Automation-group/DigitalAmmeter/photo/IMG_20190522_160255.jpg

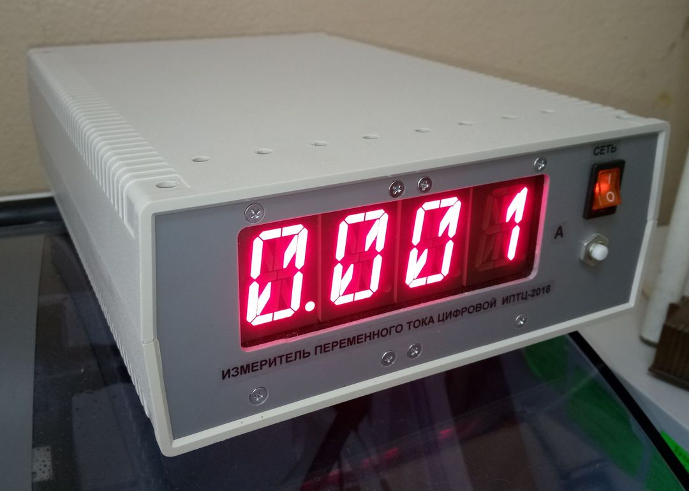
photo/IMG_20190522_160255.jpg
