Automation-group/DigitalAmmeter/photo/IMG_20190522_160238.jpg

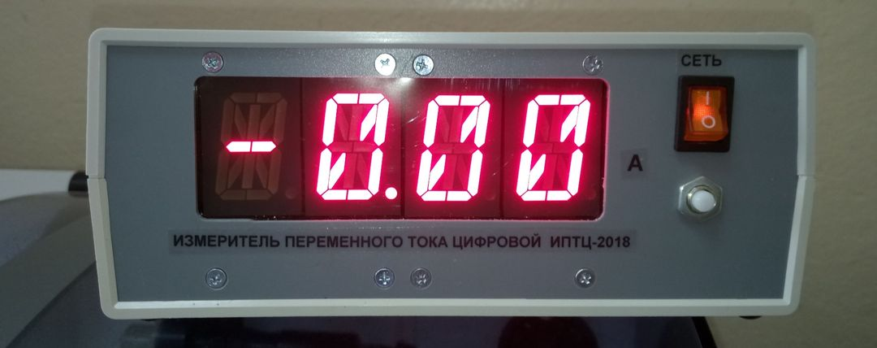
photo/IMG_20190522_160238.jpg
