Automation-group/DigitalAmmeter/source_files/Title-DA-2018.docx

ИЗМЕРИТЕЛЬ ПЕРЕМЕННОГО ТОКА ЦИФРОВОЙ ИПТЦ-2018 Тл А

СЕТЬ СЕТЬ 220 В 50 Гц ПР 1 А ВХОД USB

А/ед НИФТИ ННГУ № 01 2018 г.
