Automation-group/DigitalAmmeter/application/Application_A_7.pdf

Рис. 7

Макетное поле модуля микроконтроллера. Схема электрическая принципиальная.

Приложение А
