Automation-group/DigitalAmmeter/photo/IMG_20190522_160358.jpg

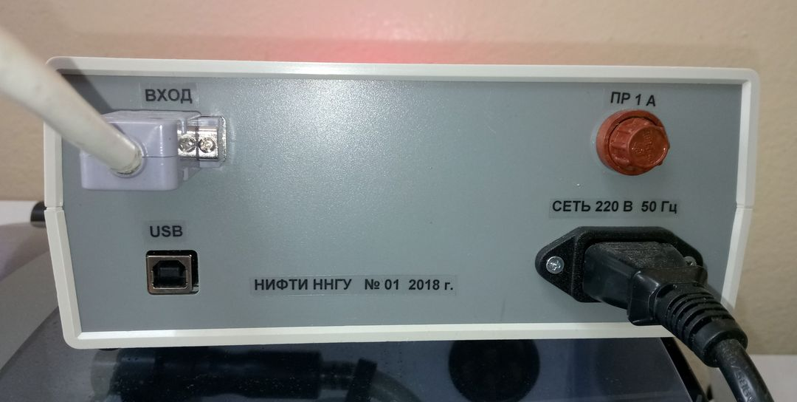
photo/IMG_20190522_160358.jpg
