Automation-group/DigitalAmmeter/application/Application_A_1.pdf

A1

## ИПТЦ-2018

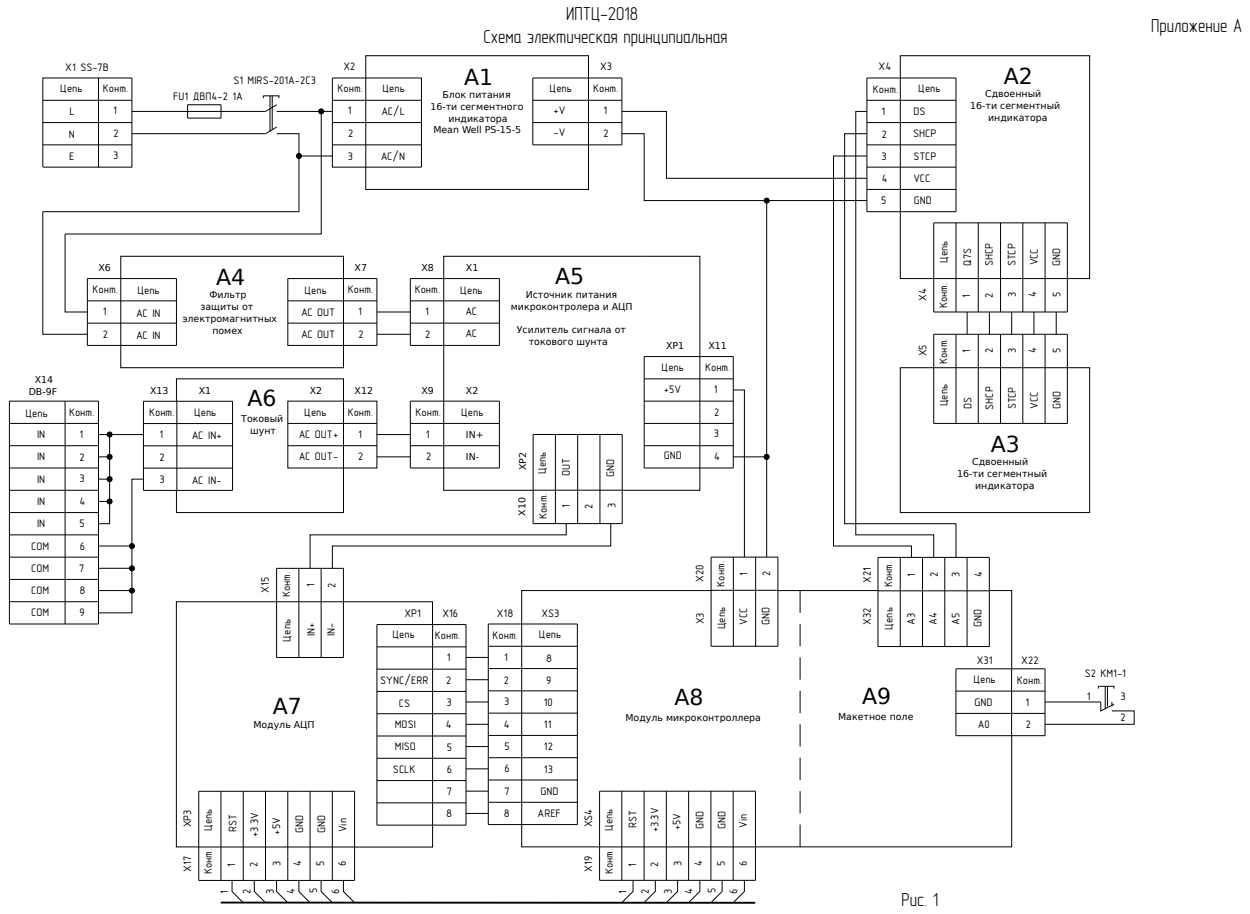
[picture p6: page 1]
Цепь; Конт.; FU1 ДВП4-2 1A; S1 MIRS-201A-2C3; Сдвоенный 16-ти сегментный индикатора; SHCP; Конт. Цепь; STCP; VCC; GND; Фильтр защиты от электромагнитных помех; AC OUT; Источник питания микроконтролера и АЦП; OUT; Токовый шунт; SYNC/ERR; MOSI; MISO; SCLK; Модуль АЦП; Модуль микроконтроллера; AC OUT+; AC OUT-; RST; Vin; AREF; Макетное поле; Схема электическая принципиальная; Приложение А; Рис. 1

Блок питания
16-ти сегментного
индикатора
Mean Well PS-15-5

3 | STCP
4 | VCC
5 | GND

Усилитель сигнала от
токового шунта

Цепь | Конт.
+5V | 1

IN | 4
IN | 5
COM | 6
COM | 7
COM | 8
COM | 9
