Automation-group/DigitalAmmeter/doc/safeduino_mega_328.pdf

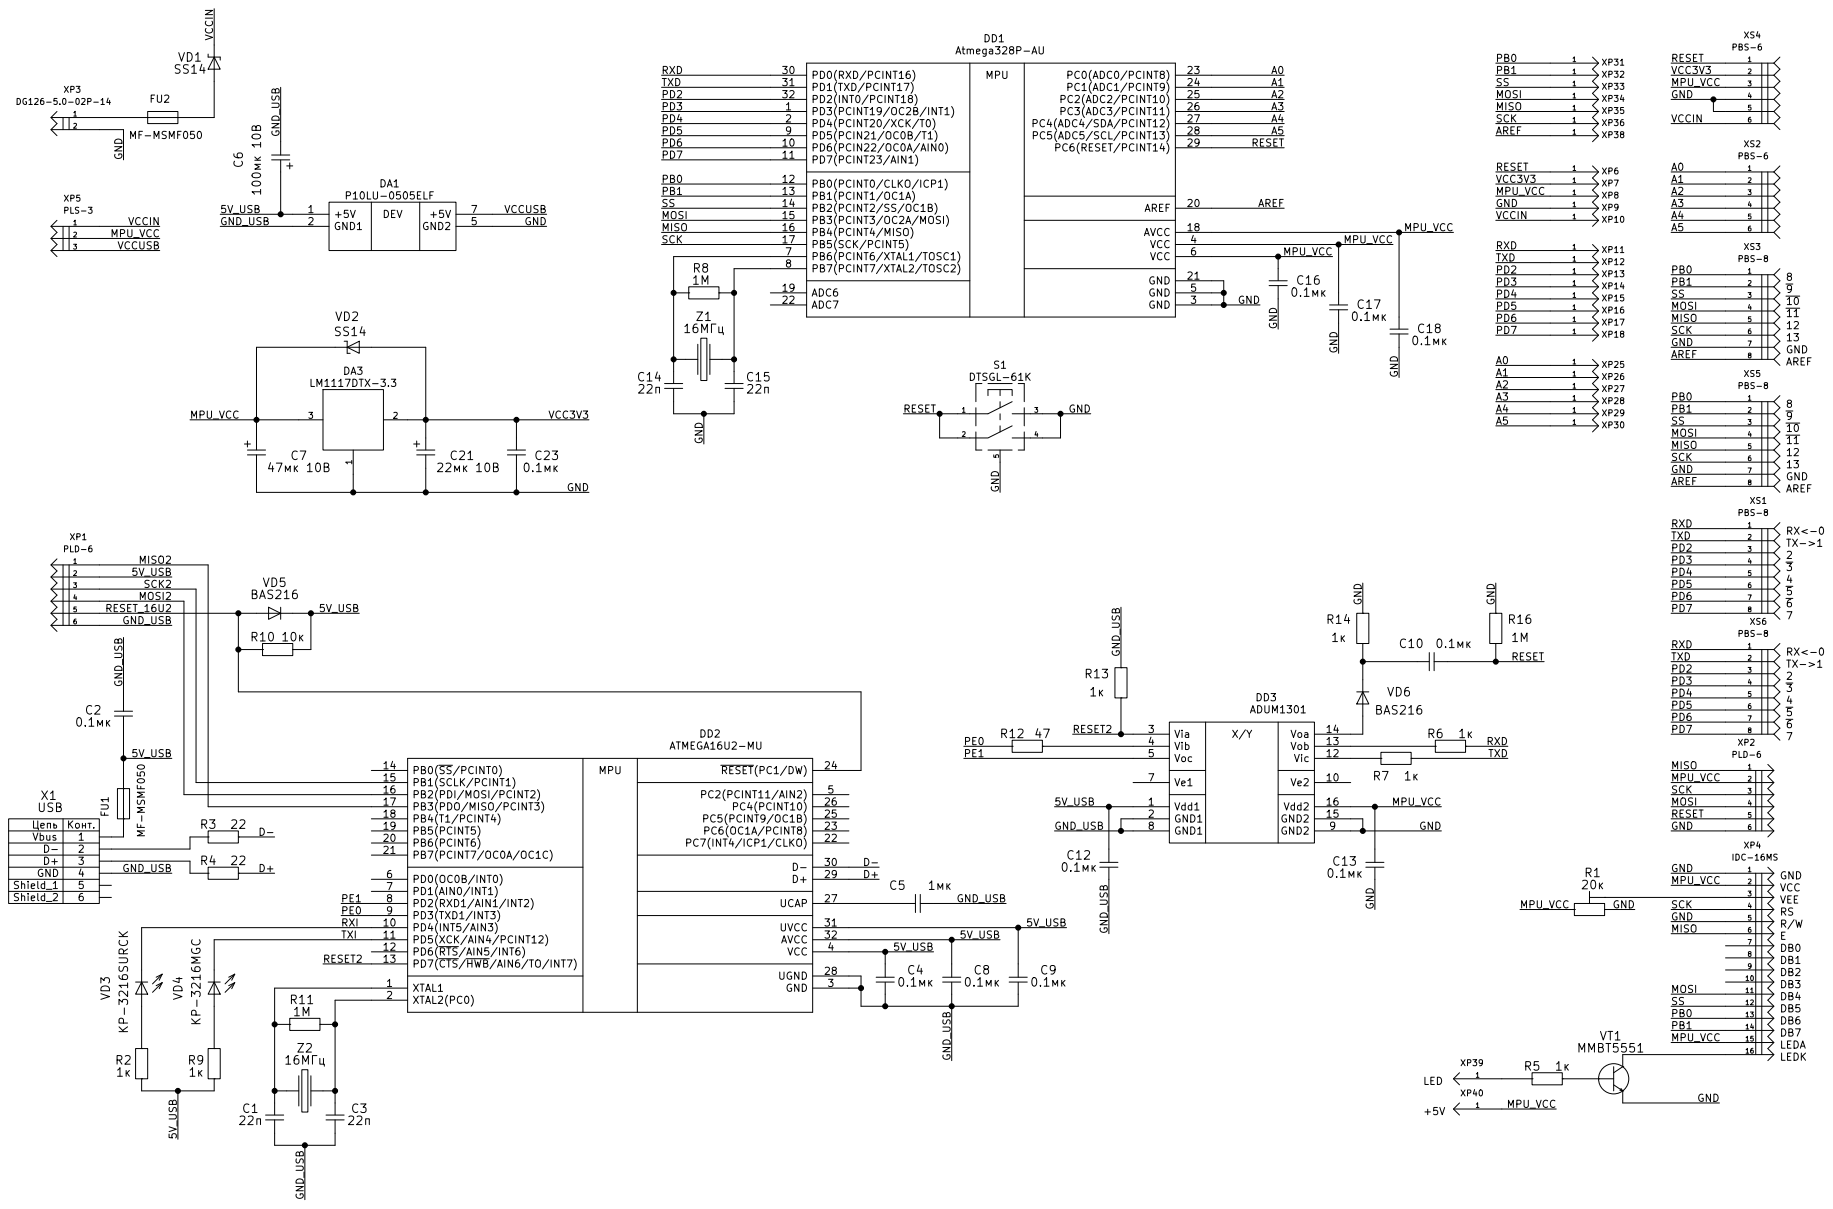
[picture p7: page 1]

Shield_2 Vbus | 6 D+D- GND 3

Shield_1 | | 5
