Automation-group/DigitalAmmeter/doc/maket_board.pdf

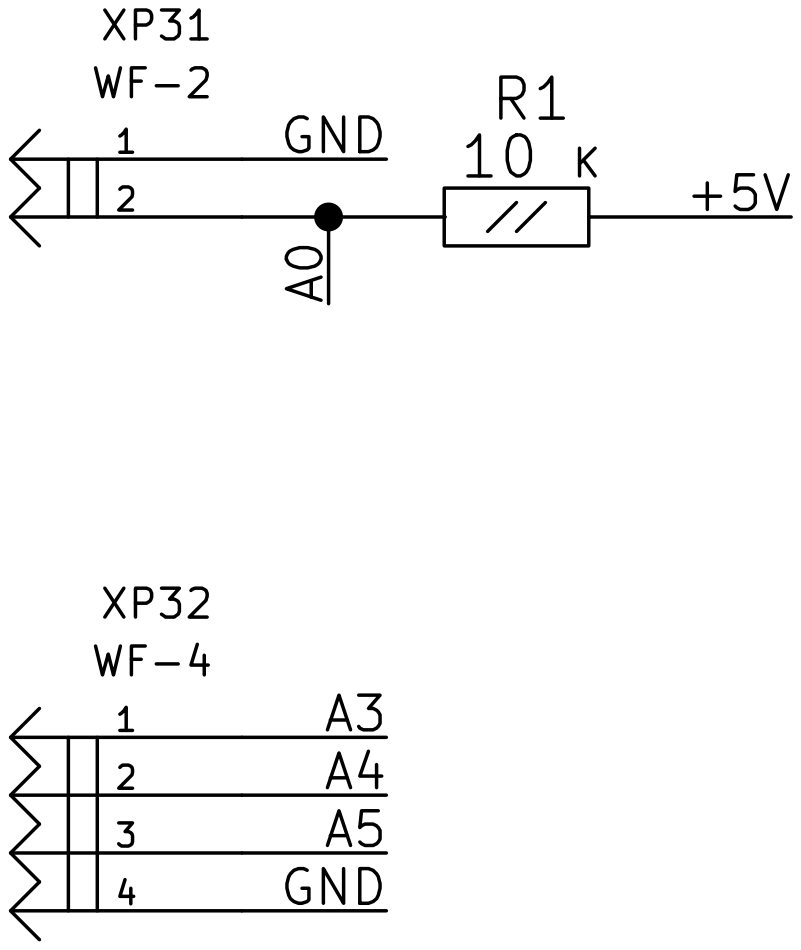
[picture p8: page 1]
