Automation-group/DigitalAmmeter/application/Application_A_2.pdf

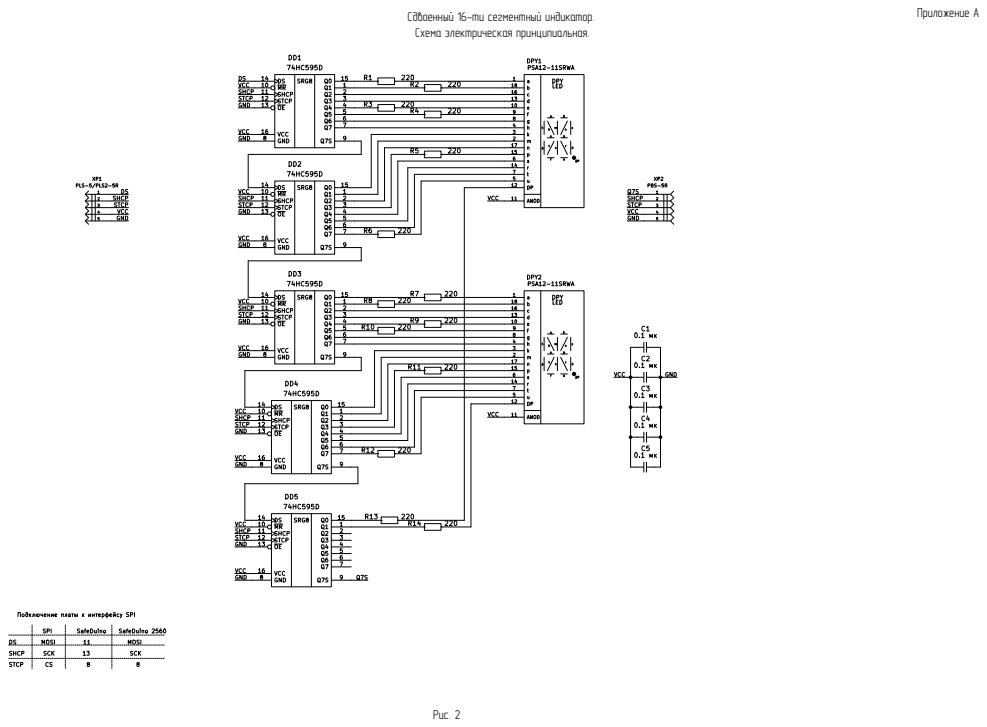
[picture p9: page 1]
Приложение А; Рис. 2

Сдвоенный 16-ти сегментный индикатор.
Схема электрическая принципиальная.
