Automation-group/DigitalAmmeter/application/Application_A_3.pdf

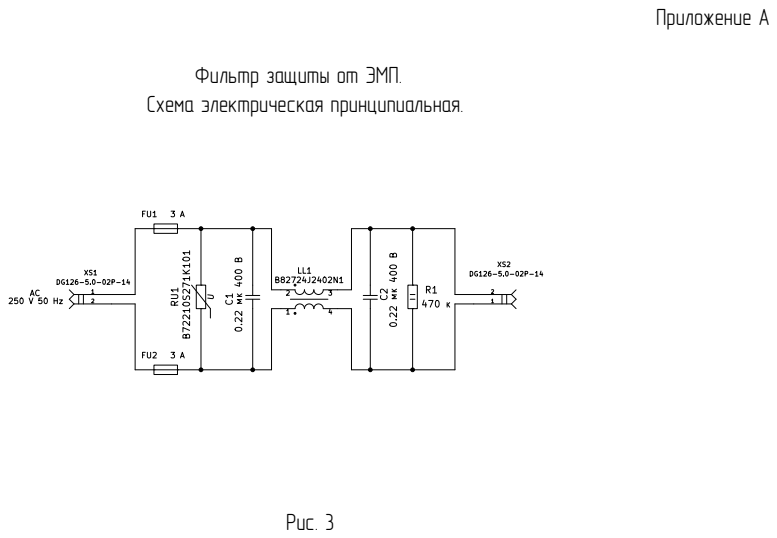
[picture p10: page 1]
Рис. 3; Приложение А

Фильтр защиты от ЭМП.
Схема электрическая принципиальная.
