Automation-group/DigitalAmmeter/application/Application_A_4.pdf

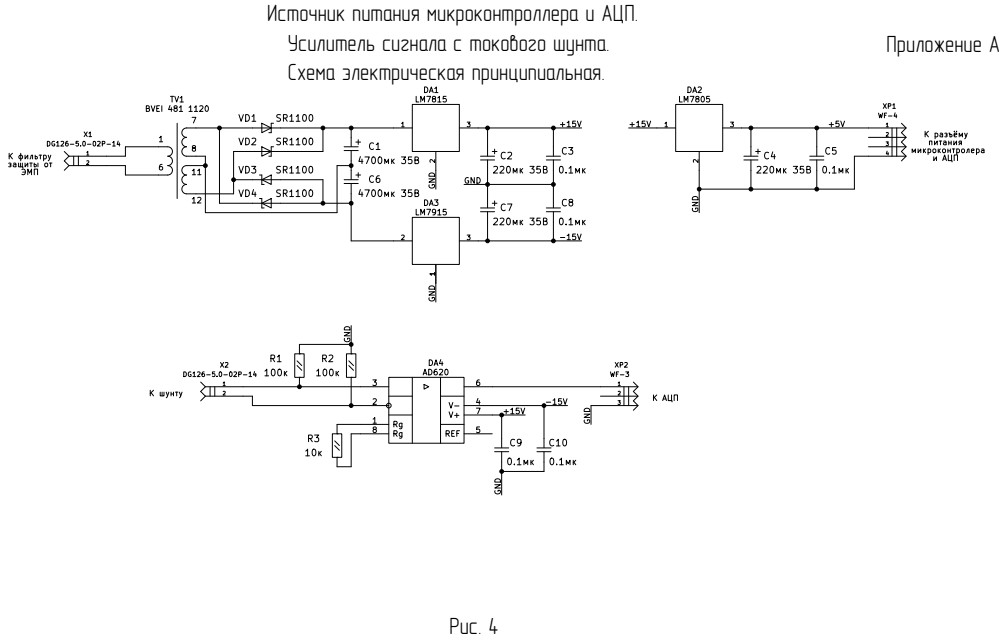
[picture p11: page 1]
Рис. 4; Приложение А

Источник питания микроконтроллера и АЦП.
Усилитель сигнала с токового шунта.
Схема электрическая принципиальная.
