Automation-group/DigitalAmmeter/application/Application_A_5.pdf

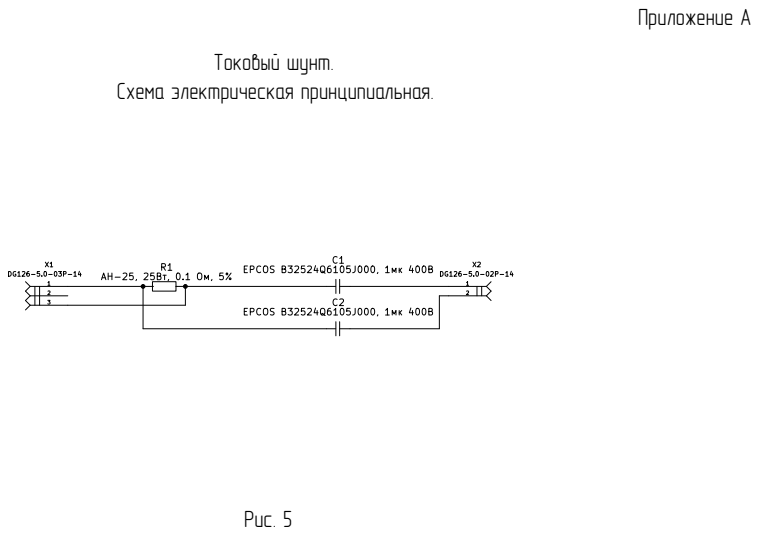
[picture p12: page 1]
Приложение А; Рис. 5; Токовый шунт.

Схема электрическая принципиальная.
