Automation-group/DigitalAmmeter/application/Application_A_6.pdf

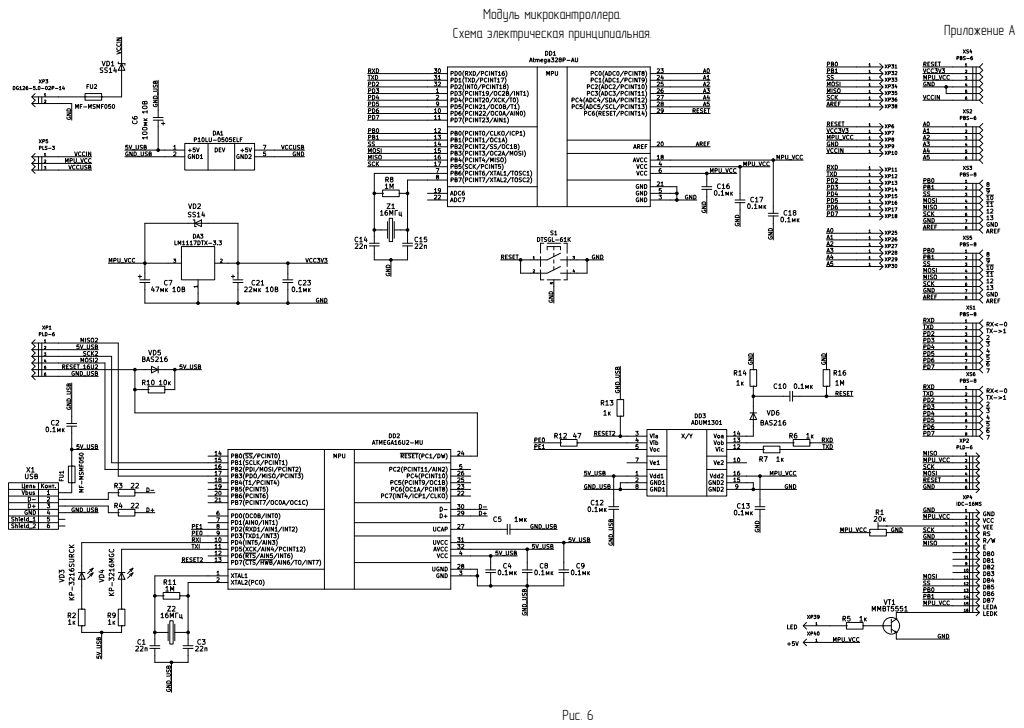
[picture p13: page 1]
Рис. 6; Модуль микрокантроллера.; Схема электрическая принципиальная.; Приложение А
