Automation-group/DigitalAmmeter/application/Application_A_8.pdf

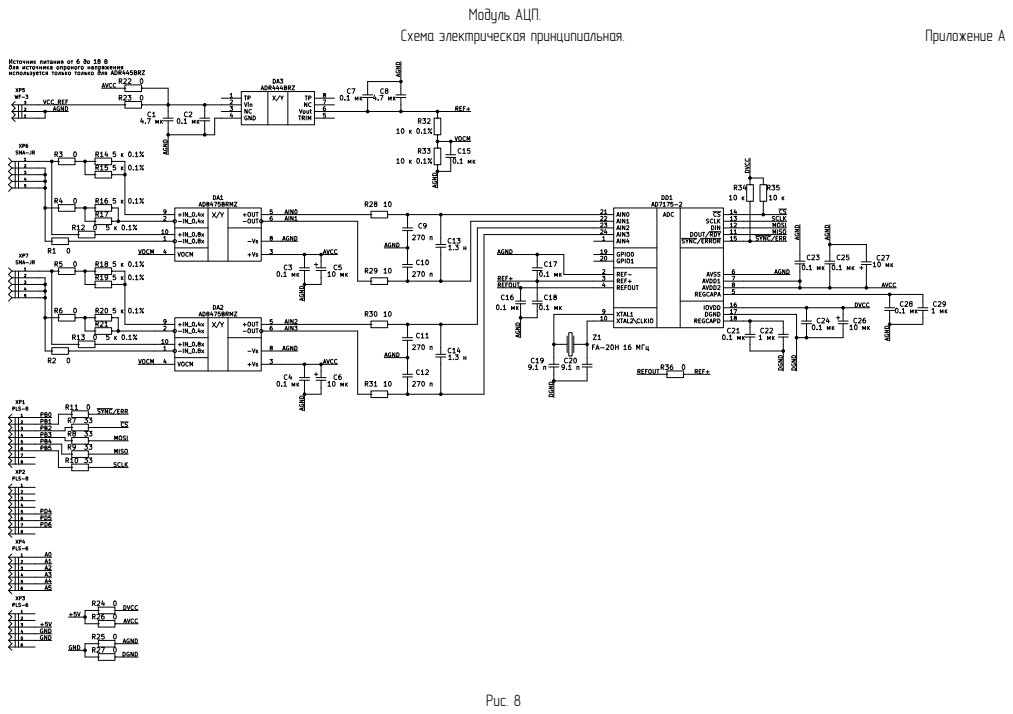
[picture p14: page 1]
Рис. 8; Модуль АЦП.; Схема электрическая принципиальная.; Приложение А
