Automation-group/DigitalAmmeter/doc/emc_filter.pdf

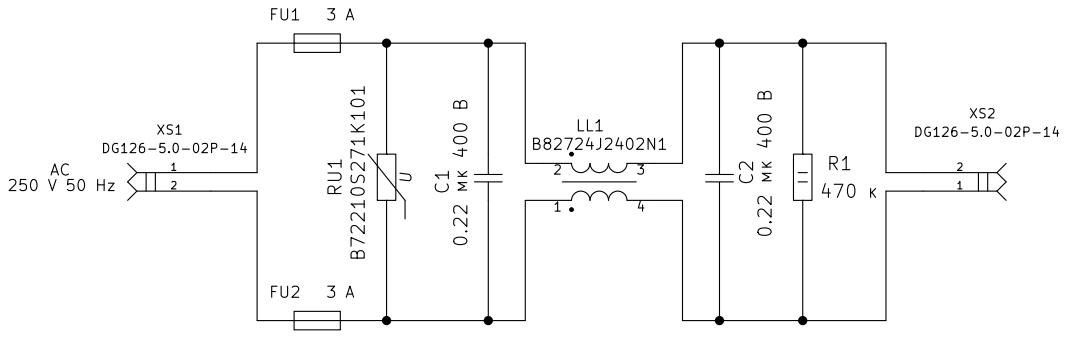
[picture p15: page 1]
