Automation-group/DigitalAmmeter/doc/mod_16_segment_LED.pdf

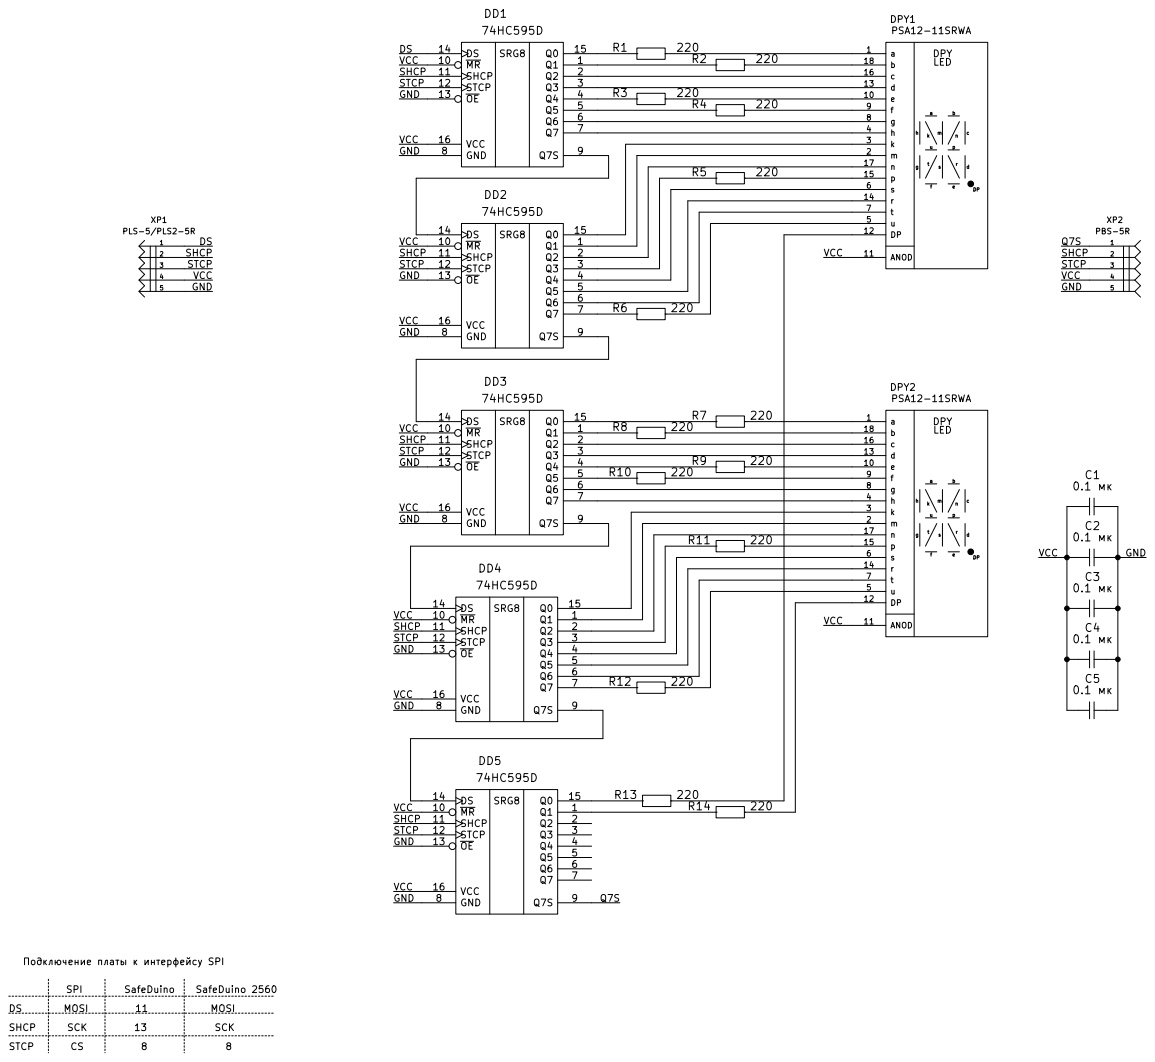
[picture p16: page 1]
