Automation-group/DigitalAmmeter/doc/modul_adc_ad7175-2.pdf

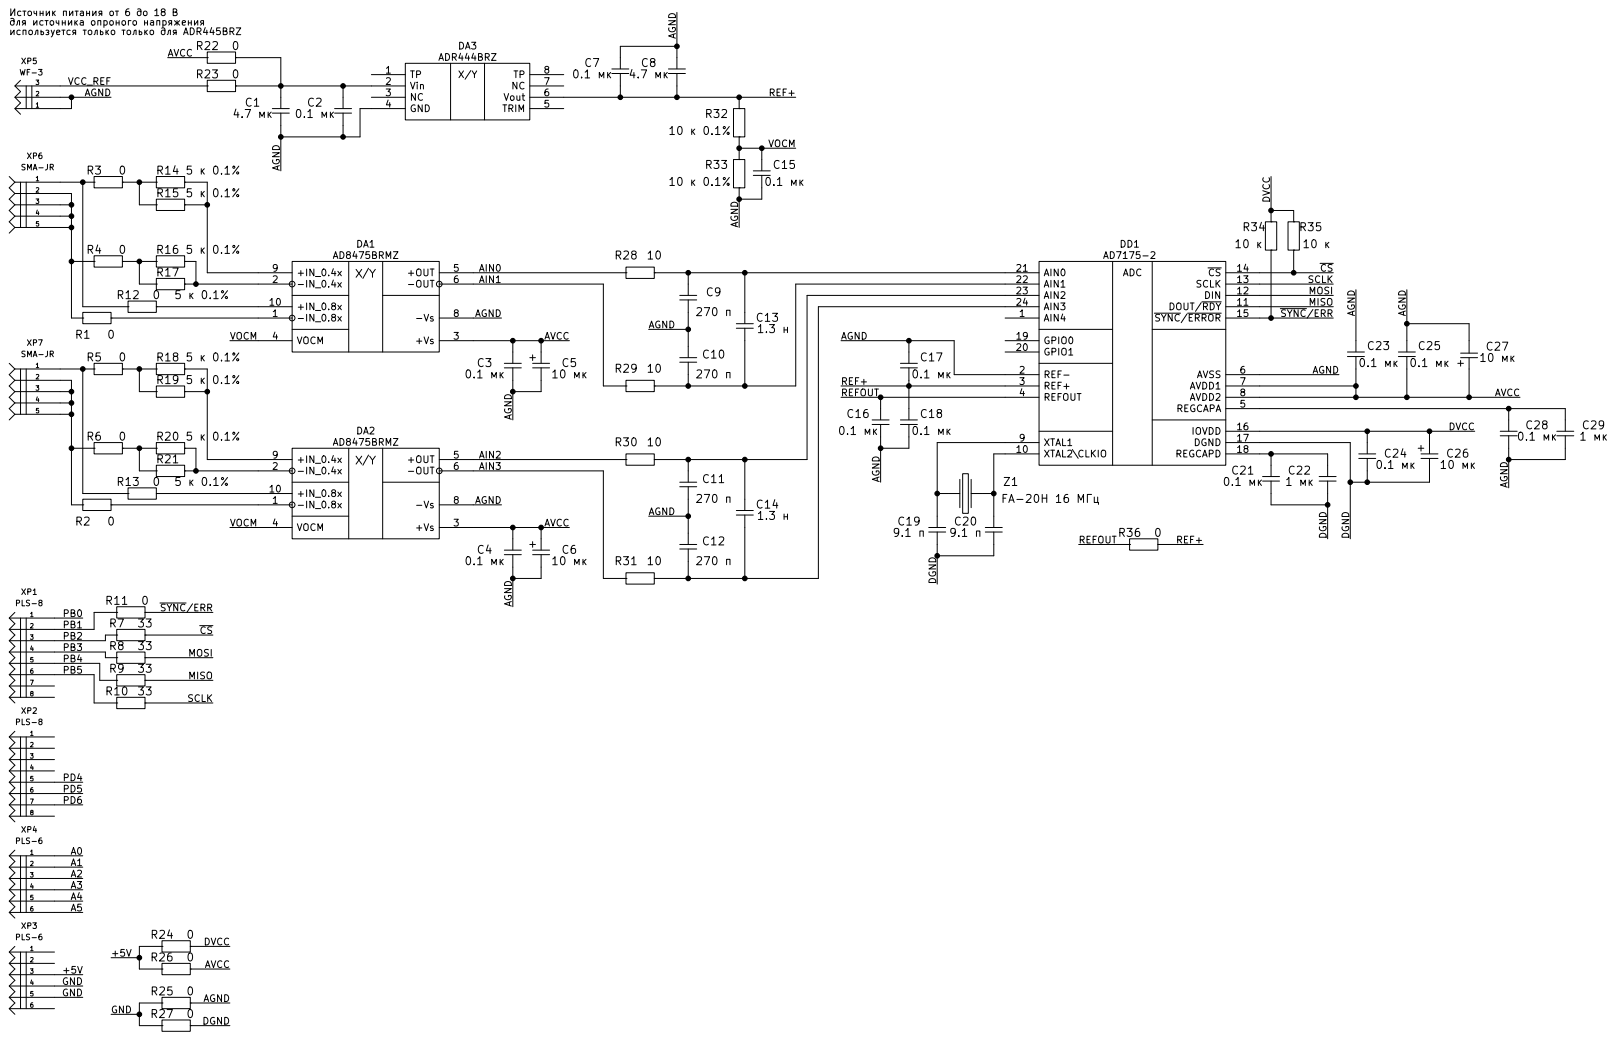
[picture p17: page 1]

MISO
SYNC/ERR
