Automation-group/DigitalAmmeter/doc/power_supply_and_instruments_amplifier.pdf

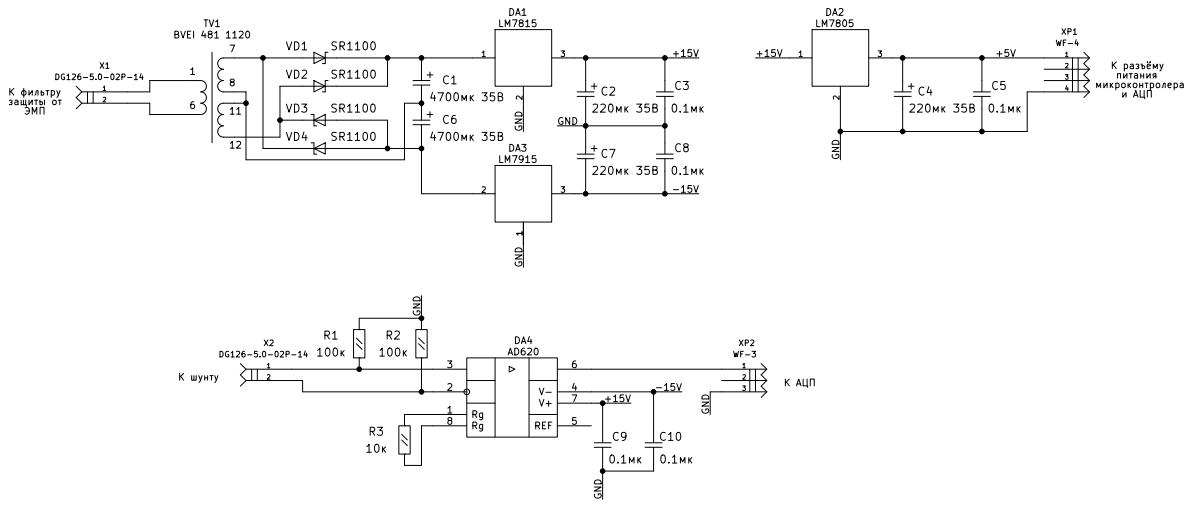
[picture p18: page 1]
